TobleMiner/smol-mppt/schematic.pdf

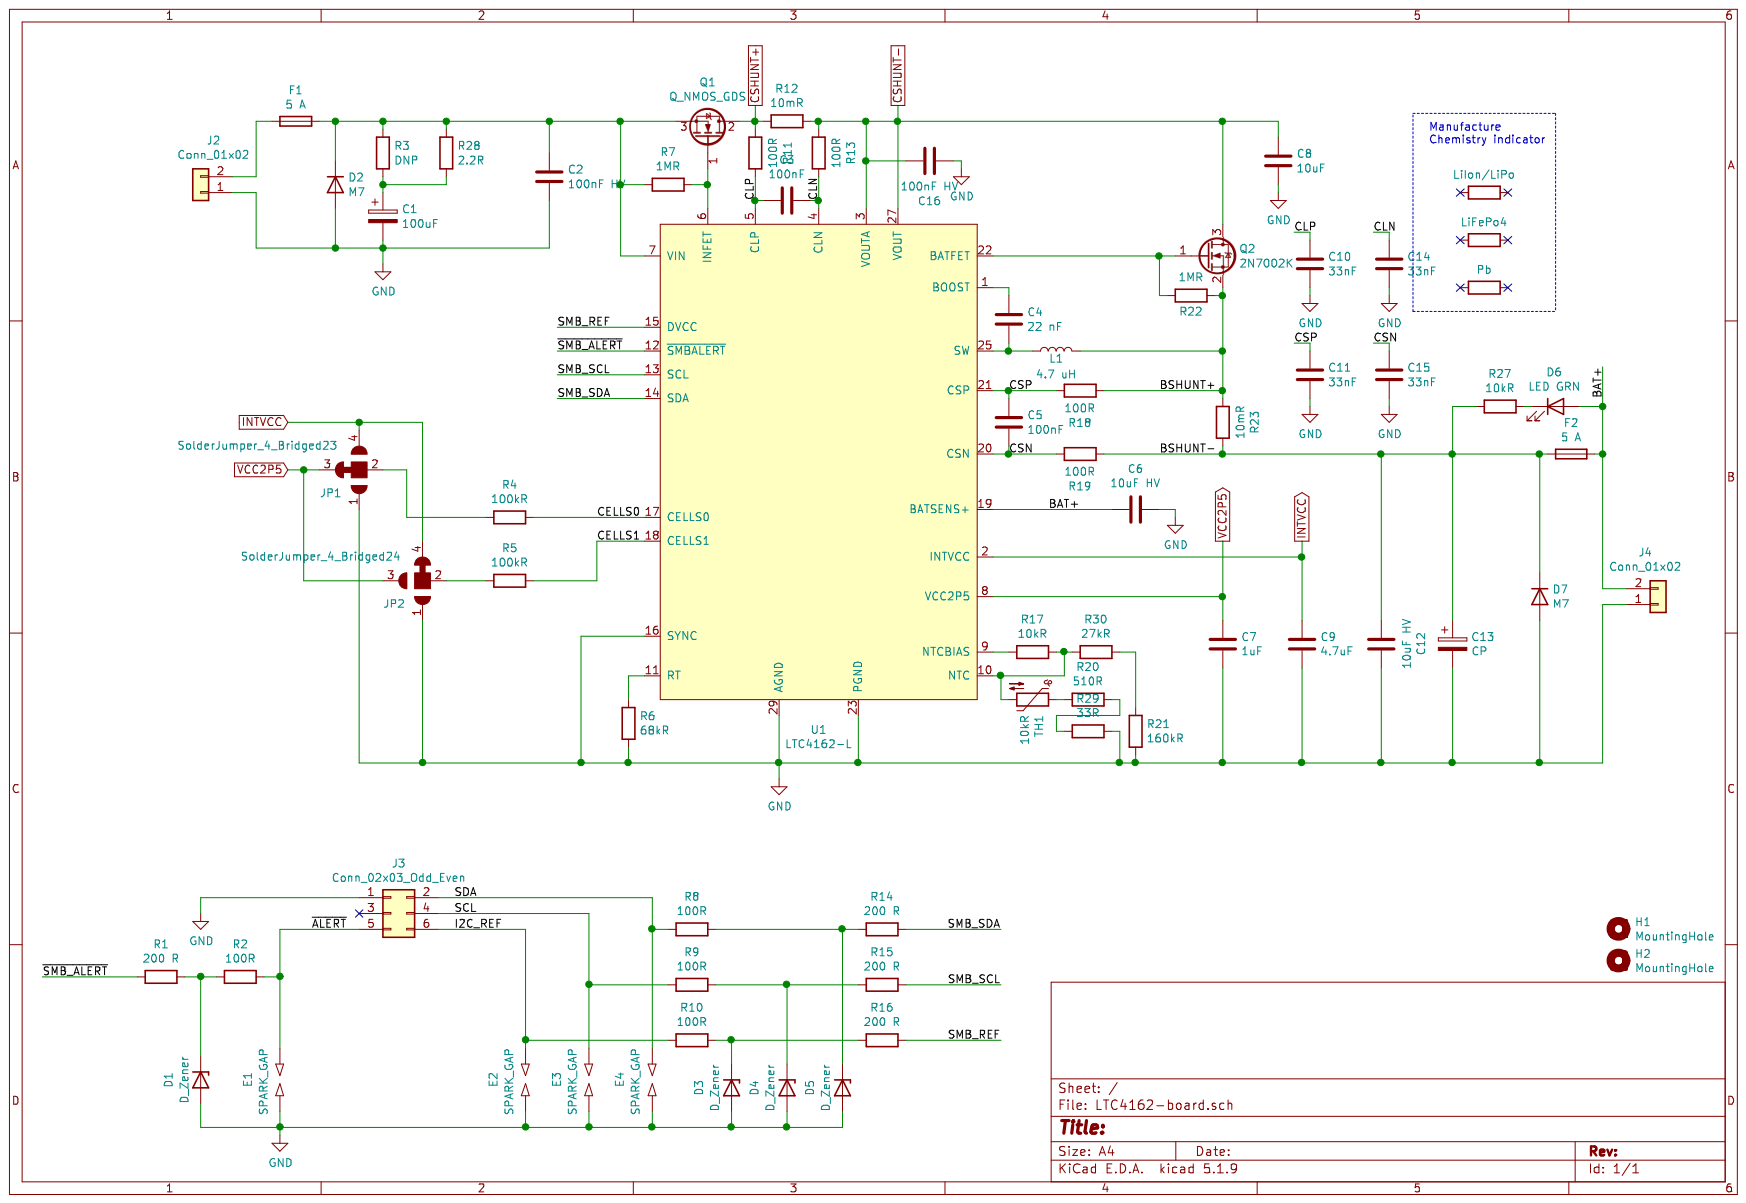
[picture p1: page 1]
