TobleMiner/smol-mppt/LTC4162-board.kicad_pcb

## KiCad design LTC4162-board.kicad_pcb (2021-02-17)

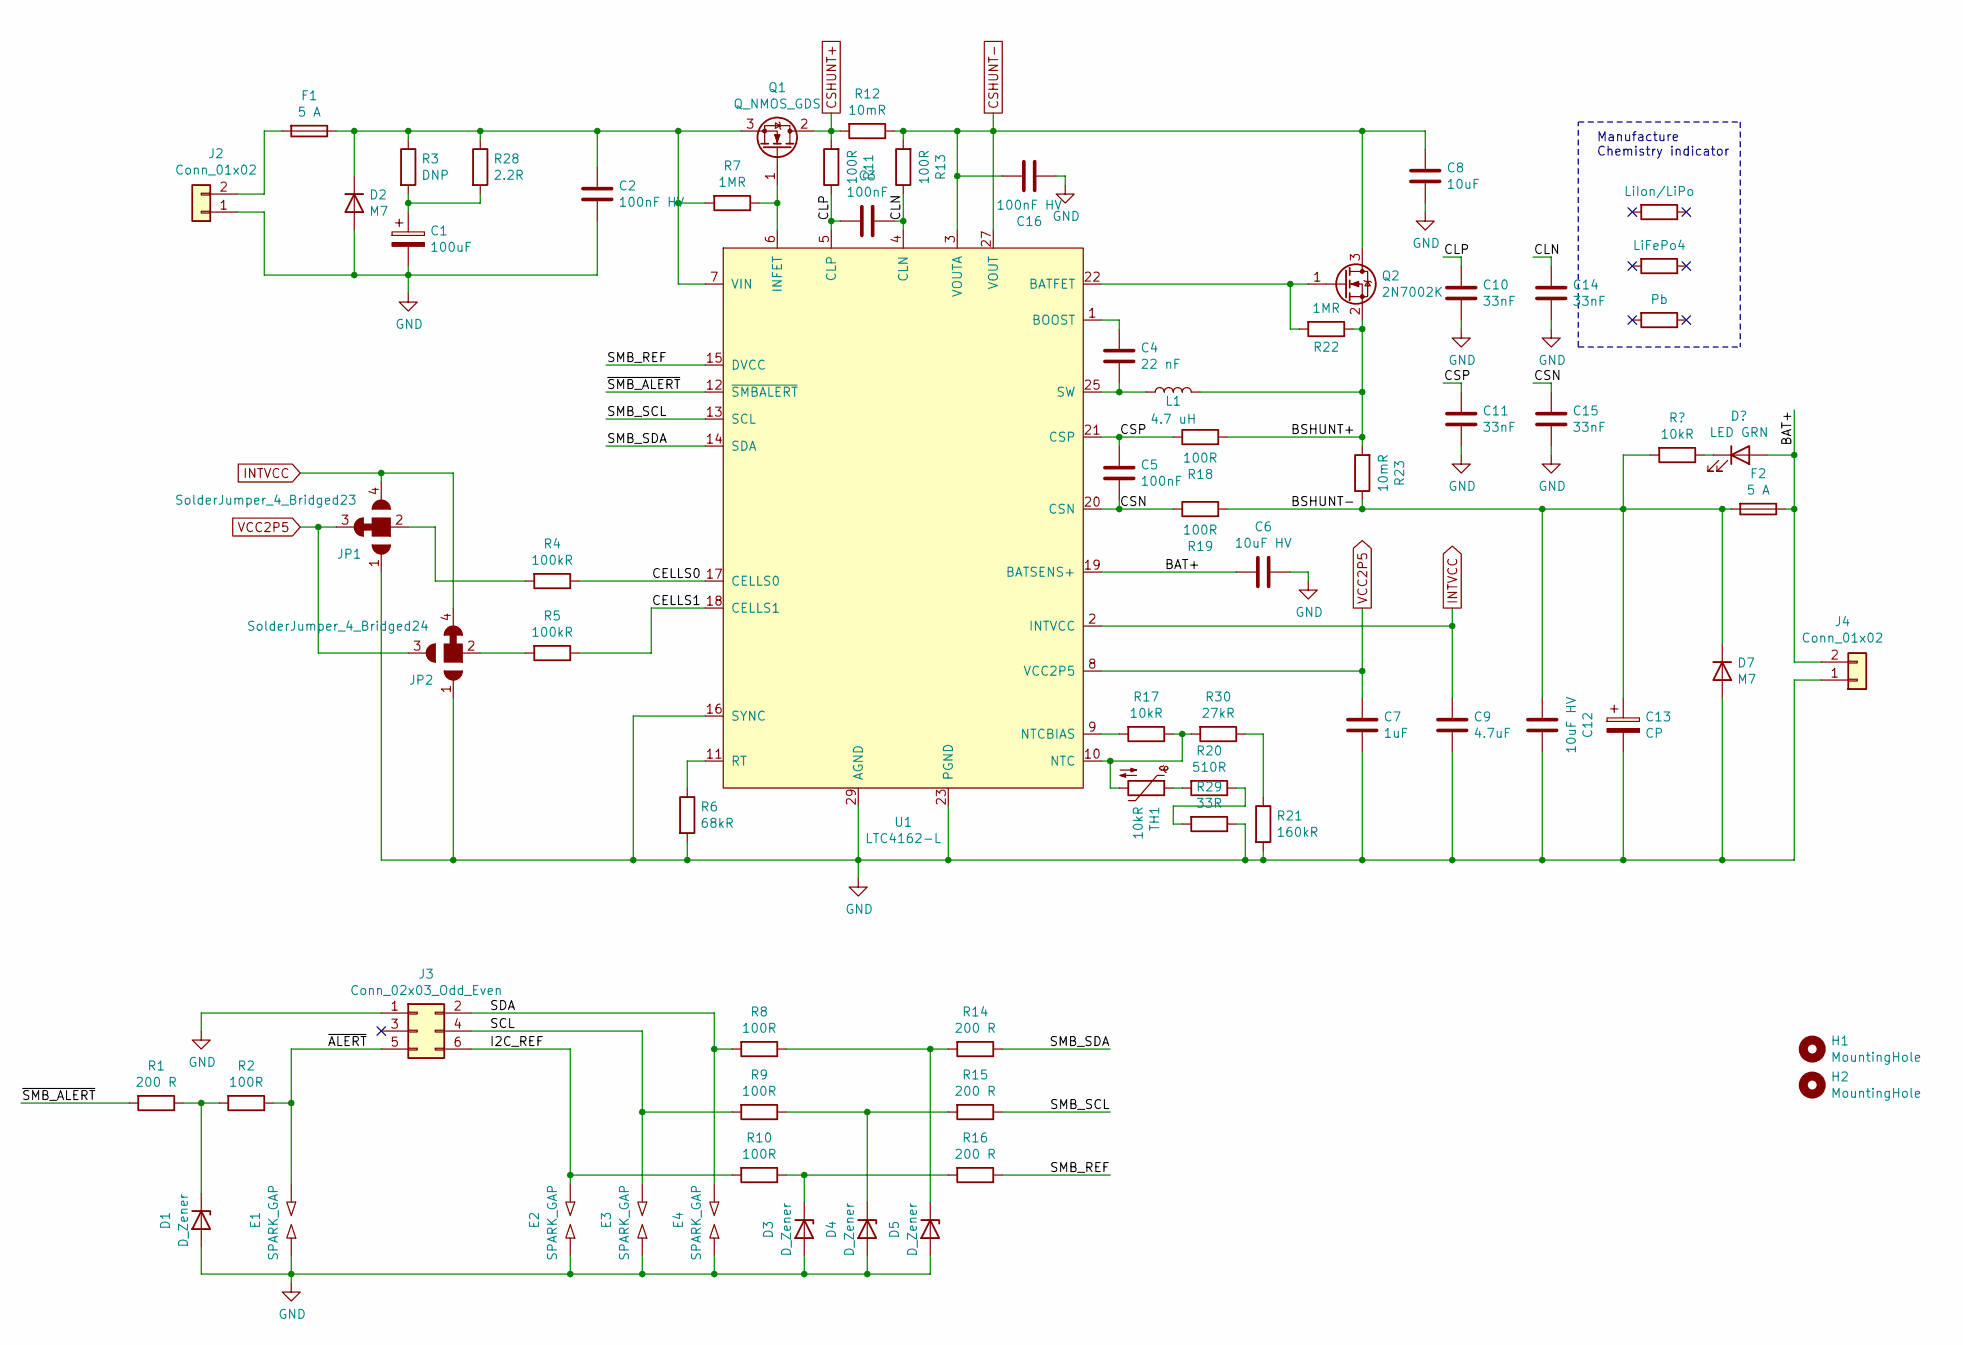
[picture p2: schematic LTC4162-board.sch]

Parts:
C1: 100uF; CP_Elec_10x10; LCSC C249996
C2, C16: 100nF HV; C_0603_1608Metric; LCSC C14663
C3, C5: 100nF; C_0402_1005Metric; LCSC C1525
C4: 22 nF; C_0402_1005Metric; LCSC C1532
C6, C12: 10uF HV; C_1206_3216Metric; LCSC C13585
C7: 1uF; C_0402_1005Metric; LCSC C52923
C8: 10uF; C_1206_3216Metric; LCSC C13585
C9: 4.7uF; C_0402_1005Metric; LCSC C23733
C10, C11, C14, C15: 33nF; C_0402_1005Metric; LCSC C1585
C13: CP; C_Elec_6.3x7.7; LCSC C249984
D1, D3, D4, D5: D_Zener; D_MiniMELF; LCSC C8062
D2, D7: M7; D_SMA; LCSC C95872
E1, E2, E3, E4: SPARK_GAP; spark-gap-0.2mm
F1, F2: 5 A; Fuse_1206_3216Metric; LCSC C182446
H1, H2: MountingHole; ToolingHole_JLCSMT
J2, J4: Conn_01x02; XT60
J3: Conn_02x03_Odd_Even; IDC-Header_2x03_P2.54mm_Vertical
JP1: SolderJumper_4_Bridged23; SolderJumper-4_P1.3mm_Bridged24_RoundedPad1.0x1.5mm
JP2: SolderJumper_4_Bridged24; SolderJumper-4_P1.3mm_Bridged23_RoundedPad1.0x1.5mm
L1: 4.7 uH; SLO0630H; LCSC C207840
Q1: Q_NMOS_GDS; TO-252-3_TabPin2; LCSC C194346
Q2: 2N7002K; SOT-23; LCSC C8545
R1, R14, R15, R16: 200 R; R_0402_1005Metric; LCSC C25087
R2, R8, R9, R10: 100R; R_0805_2012Metric; LCSC C17408
R3: DNP; R_1206_3216Metric
R4, R5: 100kR; R_0402_1005Metric; LCSC C25741
R6: 68kR; R_0402_1005Metric; LCSC C36871
R7, R22: 1MR; R_0402_1005Metric; LCSC C26083
R11, R13, R18, R19: 100R; R_0402_1005Metric; LCSC C25076
R12, R23: 10mR; R_1206_3216Metric; LCSC C26119
R17: 10kR; R_0402_1005Metric; LCSC C25744
R20: 510R; R_0402_1005Metric; LCSC C25123
R21: 160kR; R_0603_1608Metric; LCSC C22813
R24: LiIon/LiPo; R_0402_1005Metric
R25: LiFePo4; R_0402_1005Metric
R26: Pb; R_0402_1005Metric
R28: 2.2R; R_0805_2012Metric; LCSC C17521
R29: 33R; R_0402_1005Metric; LCSC C25105
R30: 27kR; R_0402_1005Metric; LCSC C25771
TH1: 10kR; R_0402_1005Metric; LCSC C92371
U1: LTC4162-L; QFN-28-1EP_4x5mm_P0.5mm_EP2.65x3.65mm_ThermalVias_backsolder

Connections:
/BAT+: C6.1, F2.1, J4.2, U1.19 (BATSENS+); also elsewhere on the board
/BSHUNT+: L1.2, Q2.2 (S), R18.2, R22.1, R23.2
/BSHUNT-: C12.1, C13.1, D7.1 (K), F2.2, R19.2, R23.1; also elsewhere on the board
/CELLS0: R4.1, U1.17 (CELLS0)
/CELLS1: R5.1, U1.18 (CELLS1)
/CLN: C3.2, C14.1, R13.1, U1.4 (CLN)
/CLP: C3.1, C10.1, R11.1, U1.5 (CLP)
/CSN: C5.2, C15.1, R19.1, U1.20 (CSN)
/CSP: C5.1, C11.1, R18.1, U1.21 (CSP)
/I2C_REF: E2.1, J3.6, R10.2
/SCL: E3.1, J3.4, R9.2
/SDA: E4.1, J3.2, R8.2
/SMB_REF: R16.1, U1.15 (DVCC)
/SMB_SCL: R15.1, U1.13 (SCL)
/SMB_SDA: R14.1, U1.14 (SDA)
/~ALERT: E1.1, J3.5, R2.1
/~SMB_ALERT: R1.2, U1.12 (~SMBALERT)
CSHUNT+: Q1.2 (D), R11.2, R12.2
CSHUNT-: C8.1, C16.2, Q2.3 (D), R12.1, R13.2, U1.3 (VOUTA), U1.27 (VOUT), U1.28 (VOUT)
GND: C1.2, C2.2, C6.2, C7.2, C8.2, C9.2, C10.2, C11.2, C12.2, C13.2, C14.2, C15.2, C16.1, D1.2 (A), D2.2 (A), D3.2 (A), D4.2 (A), D5.2 (A), D7.2 (A), E1.2, E2.2, E3.2, E4.2, J2.1, J3.1, J4.1, JP1.1, JP2.1, R6.2, R21.2, R29.1, U1.16 (SYNC), U1.23 (PGND), U1.24 (PGND), U1.29 (AGND)
INTVCC: C9.1, JP1.4, JP2.4, U1.2 (INTVCC)
unnamed: C1.1, R3.2, R28.2
unnamed: C2.1, D2.1 (K), F1.1, Q1.3 (S), R3.1, R7.2, R28.1, U1.7 (VIN)
unnamed: C4.1, U1.1 (BOOST)
unnamed: C4.2, L1.1, U1.25 (SW), U1.26 (SW)
unnamed: D1.1 (K), R1.1, R2.2
unnamed: D3.1 (K), R10.1, R16.2
unnamed: D4.1 (K), R9.1, R15.2
unnamed: D5.1 (K), R8.1, R14.2
unnamed: F1.2, J2.2
unnamed: JP1.2, R4.2
unnamed: JP2.2, R5.2
unnamed: Q1.1 (G), R7.1, U1.6 (INFET)
unnamed: Q2.1 (G), R22.2, U1.22 (BATFET)
unnamed: R6.1, U1.11 (RT)
unnamed: R17.1, R30.2, TH1.2, U1.10 (NTC)
unnamed: R17.2, U1.9 (NTCBIAS)
unnamed: R20.1, R29.2
unnamed: R20.2, TH1.1
unnamed: R21.1, R30.1
VCC2P5: C7.1, JP1.3, JP2.3, U1.8 (VCC2P5)

Notes on the sheet:
Manufacture Chemistry indicator

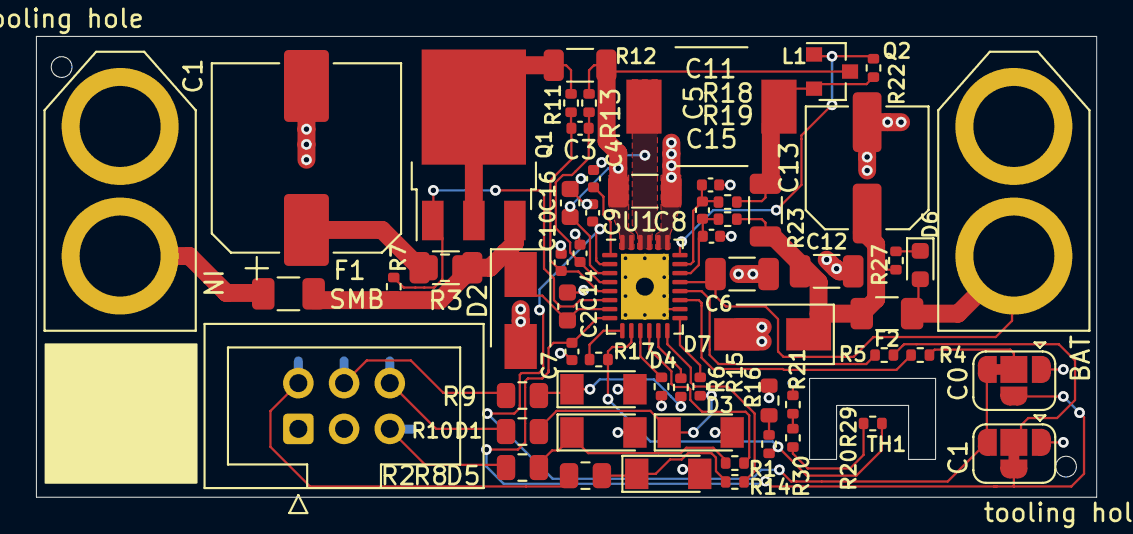
[picture p3: board LTC4162-board.kicad_pcb from above]

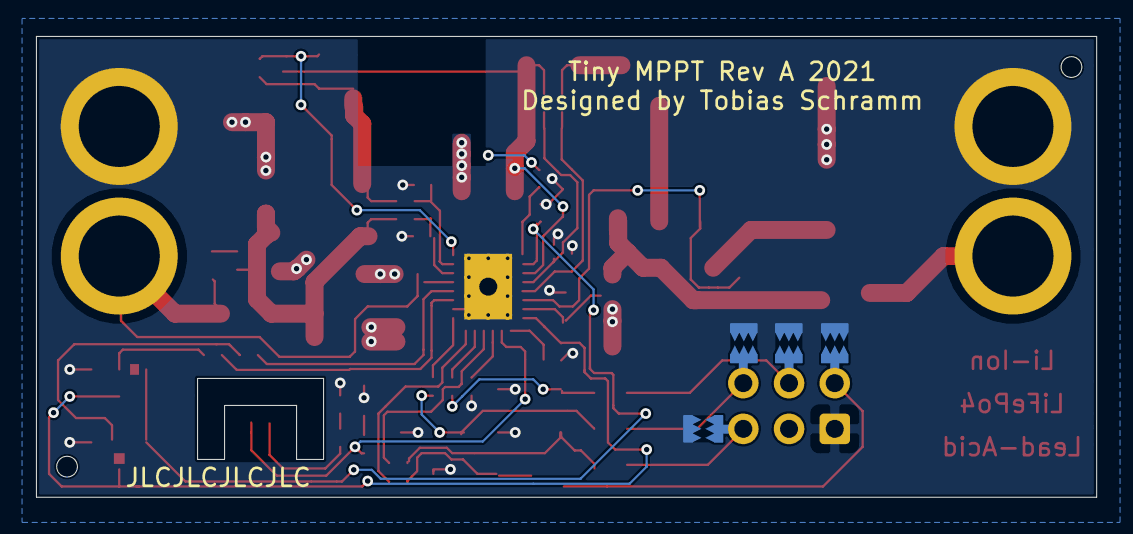
[picture p4: board LTC4162-board.kicad_pcb from below]

Board: 2 copper layers, 58.9 x 25.6 mm, 71 parts (4 on the bottom side), 42 nets.

Other parts of the board:
D6: LED GRN; LED_0603_1608Metric
R27: 10kR; R_0402_1005Metric

Their connections:
/BAT+: D6.2; also elsewhere on the board
/BSHUNT-: R27.2; also elsewhere on the board
unnamed: D6.1, R27.1
