TobleMiner/smol-mppt/(commit log)

2021-02-17 Optimize for basic parts
    [LTC4162-board.kicad_pcb, LTC4162-board.sch, MPPT-power-pack.sch]
2021-02-17 Export schematic as pdf
    [LTC4162-board.sch]
2021-02-17 Improve bypassing
    * Replace input wet electrolytic by solid polymer cap
    * Bypass charge output with wet electrolytic
    * Bypass both output and batsense+ with 10uF MLCC
    [LTC4162-board.kicad_pcb, LTC4162-board.sch]
